Q1anWan/ControlBordL4/README.md

# ControlBordL4
A STM32 L431 Control Board  
分拣机控制器第二版  
-四层PCB  
-添加IMU  
-优化引脚引出方案
