Q1anWan/ControlBordL4/Hardware/BOM_V2.1_2022-09-01.xlsx

No. | Quantity | Comment | Designator | Footprint | Value | Manufacturer Part | Manufacturer | Supplier Part | Supplier
1 | 3 | 100nF | C1,C10,C11 | C0603 | 100nF | CC0603KRX7R9BB104 | YAGEO(国巨) | C14663 | LCSC
2 | 7 | 100nF | C2,C5,C6,C15,C16,C22,C28 | C0603 | 100nF | CL10B104KC8NNNC | SAMSUNG(三星) | C15725 | LCSC
3 | 3 | 22uF | C3,C4,C21 | C0805 | 22uF | C3216X5R1V226M160AC | TDK | C69612 | LCSC
4 | 1 | 8.2nF | C7 | C0603 | 8.2nF | 0603B822J500CT | 华新科(Walsin) | C458884 | LCSC
5 | 1 | 10pF | C8 | C0603 | 10pF | CC0603GRNPO9BN100 | YAGEO(国巨) | C325468 | LCSC
6 | 1 | 1nF | C9 | C0603 | 1nF | CL10B102KB8NNNC | SAMSUNG(三星) | C1588 | LCSC
7 | 1 | 47uF | C12 | CAP-SMD_L3.5-W2.8-R-RD | 47uF | CA45-B-16V-47uF-K | CEC(振华新云) | C136751 | LCSC
8 | 2 | 22uF | C13,C14 | C0603 | 22uF | ZRB18AR60J226ME01L | muRata(村田) | C913515 | LCSC
9 | 2 | 100nF | C17,C20 | C0402 | 100nF | CGA2B3X7R1V104MT0Y0F | TDK | C2802700 | LCSC
10 | 2 | 10uF | C18,C19 | CAP-SMD_L3.5-W2.8-R-RD | 10uF | TC211B106K025Y | Sunlord(顺络) | C110181 | LCSC
11 | 1 | 22pF | C23 | C0603 | 22pF | GCM1885C2A220JA16D | muRata(村田) | C408549 | LCSC
12 | 12 | 100nF | C24,C25,C29,C30,C31,C32,C33,C36,C40,C41,C42,C43 | C0402 | 100nF | GCM155R71C104KA55J | muRata(村田) | C2655418 | LCSC
13 | 2 | 100nF | C26,C27 | C0603 | 100nF | TCC0603X7R104K500CT | CCTC(三环) | C282519 | LCSC
14 | 1 | 4.7uF | C34 | C0603 | 4.7uF | GRM188C81E475KE11D | muRata(村田) | C417145 | LCSC
15 | 1 | 10nF | C35 | C0603 | 10nF | C0603C103K1RACAUTO | KEMET(基美) | C141072 | LCSC
16 | 1 | 1uF | C37 | C0603 | 1uF | 0603F105M160NT | FH(风华) | C1689 | LCSC
17 | 2 | 20pF | C38,C39 | C0603 | 20pF | 0603CG200G500NT | FH(风华) | C165733 | LCSC
18 | 1 | 3110-08SG0BK00A1 | CN2 | IDC-TH_3110-08SG0BK00A1 |  | 3110-08SG0BK00A1 | Wcon(维峰电子) | C720734 | LCSC
19 | 1 | X9821WVS-04-9TSN | CN3 | CONN-SMD_4P-P1.25_X9821WVS-04-9TSN |  | X9821WVS-04-9TSN | XKB Connectivity(中国星坤) | C397365 | LCSC
20 | 1 | XT30UPB-M | CN11 | CONN-TH_XT30UPB-M |  | XT30UPB-M | AMASS(艾迈斯) | C428721 | LCSC
21 | 1 | XT30UPB-F | CN12 | CONN-TH_XT30UPB-F |  | XT30UPB-F | AMASS(艾迈斯) | C108769 | LCSC
22 | 2 | A1257WR-S-2P | CN13,CN14 | CONN-SMD_A1257WR-S-2P |  | A1257WR-S-2P | CJT(长江连接器) | C225125 | LCSC
23 | 2 | DSK310 | D1,D3 | SOD-123_L2.7-W1.8-LS3.7-RD |  | DSK310 | LGE(鲁光) | C713648 | LCSC
24 | 1 | ZMM9V1 | D2 | LL-34_L3.5-W1.5-RD |  | ZMM9V1 | Slkor(萨科微) | C707200 | LCSC
25 | 10 | PESD5V0L1BA | D4,D5,D6,D7,D8,D9,D10,D11,D12,D13 | SOD-323_L1.7-W1.3-LS2.5-BI |  | PESD5V0L1BA | TECH PUBLIC(台舟) | C2827691 | LCSC
26 | 4 | M2.5 | H1,H2,H3,H4 | M2.5
27 | 1 | 6.8uH | L1 | IND-SMD_L6.6-W6.6 | 6.8uH | SMMS0630-6R8M | SXN(顺翔诺) | C128690 | LCSC
28 | 1 | 4.7uH | L2 | IND-SMD_L4.5-W4.0-1 | 4.7uH | MCS0420-4R7MPN2 | PSA(信昌电陶) | C2937092 | LCSC
29 | 2 | NCD0805R1 | LED1,LED2 | LED0805-RD_RED |  | NCD0805R1 | 国星光电 | C84256 | LCSC
30 | 1 | HL-PCF-3216S39FU70GH203BC-A | LED3 | LED-SMD_4P-L3.2-W1.5-BL |  | HL-PCF-3216S39FU70GH203BC-A | HONGLITRONIC(鸿利光电) | C513366 | LCSC
31 | 1 | WSD3066DN33 | Q1 | DFN-8_L3.3-W3.3-P0.65-BL |  | WSD3066DN33 | WINSOK微硕 | C148386 | LCSC
32 | 1 | AO3400 | Q2 | SOT-23_L2.9-W1.3-P1.90-LS2.4-BR |  | AO3400 | GOODWORK(固得沃克) | C2938367 | LCSC
33 | 1 | PMBT3904,235 | Q3 | SOT-23-3_L2.9-W1.3-P1.90-LS2.3-BR-1 |  | PMBT3904,235 | Nexperia(安世) | C179417 | LCSC
34 | 1 | 10kΩ | R1 | R0603 | 10kΩ | AR03BTD1002 | Viking(光颉) | C2992491 | LCSC
35 | 4 | 0Ω | R2,R5,R9,R20 | R0805 | 0Ω | 0805W8F0000T5E | UNI-ROYAL(厚声) | C17477 | LCSC
36 | 1 | 47kΩ | R3 | R0603 | 47kΩ | RS-03K473JT | FH(风华) | C115419 | LCSC
37 | 2 | 40.2kΩ | R4,R10 | R0603 | 40.2kΩ | TC0325B4022T5E | UNI-ROYAL(厚声) | C95611 | LCSC
38 | 1 | 5.1kΩ | R6 | R0603 | 5.1kΩ | RG1608P-512-B-T5 | SUSUMU | C332218 | LCSC
39 | 2 | 7.68kΩ | R7,R11 | R0603 | 7.68kΩ | RMC06037.68K1%N | Tyohm(幸亚电阻) | C269511 | LCSC
40 | 3 | 5.1kΩ | R8,R13,R14 | R0603 | 5.1kΩ | RMC06035.1K1%N | Tyohm(幸亚电阻) | C269716 | LCSC
41 | 1 | 5.1kΩ | R12 | R0603 | 5.1kΩ | RMC06035.1K5%N | Tyohm(幸亚电阻) | C269696 | LCSC
42 | 2 | 56Ω | R15,R16 | R0603 | 56Ω | CR0603JA0560G | LIZ(丽智电子) | C101366 | LCSC
43 | 3 | 120Ω | R17,R18,R19 | R0603 | 120Ω | RTT03121JTP | RALEC(旺诠) | C103256 | LCSC
44 | 1 | 10.2kΩ | R21 | R0603 | 10.2kΩ | 0603WAF1022T5E | UNI-ROYAL(厚声) | C22772 | LCSC
45 | 1 | 5.1kΩ | R22 | R0603 | 5.1kΩ | RS-03K512JT | FH(风华) | C73801 | LCSC
46 | 3 | 2.1kΩ | R23,R24,R25 | R0603 | 2.1kΩ | 0603WAF2101T5E | UNI-ROYAL(厚声) | C22902 | LCSC
47 | 2 | 10kΩ | R26,R27 | R0603 | 10kΩ | SG73P1JTTD1002F | KOA | C880254 | LCSC
48 | 2 | YD-3410 | SW1,SW2 | SW-SMD_L3.9-W2.9-LS4.8-EH-A |  | YD-3410 |  | C9900006416 | LCSC
49 | 1 | TPS54531DDAR | U1 | SOIC-8_L5.0-W4.0-P1.27-LS6.0-BL-EP2.0 |  | TPS54531DDAR | TI(德州仪器) | C50605 | LCSC
50 | 1 | SK6019AD4-33 | U2 | XDFN-4_L1.0-W1.0-P0.65-BL-EP |  | SK6019AD4-33 | 洺太电子(suntek) | C2682762 | LCSC
51 | 1 | RY8411 | U3 | SOT-23-6_L2.9-W1.6-P0.95-LS2.8-TL |  | RY8411 | RYCHiP(蕊源) | C2935411 | LCSC
52 | 1 | CH340N | U4 | SOP-8_L4.9-W3.9-P1.27-LS6.0-BL |  | CH340N | WCH(南京沁恒) | C2977777 | LCSC
53 | 7 | PH-00014 | U5,U24,U25,U26,U27,U28,U29 | HDR-TH_3P-P2.54-V-M |  | PH-00014 | Liansheng(连盛) | C2685130 | LCSC
54 | 1 | TJA1042T/1J | U6 | SOIC-8_L5.0-W4.0-P1.27-LS6.0-BL |  | TJA1042T/1J | NXP(恩智浦) | C53670 | LCSC
55 | 1 | STM32L431RCT6 | U7 | LQFP-64_L10.0-W10.0-P0.50-LS12.0-BL |  | STM32L431RCT6 | ST(意法半导体) | C92468 | LCSC
56 | 1 | BMI160 | U8 | LGA-14_L3.0-W2.5-P0.50-BL |  | BMI160 | Bosch(博世) | C94021 | LCSC
57 | 1 | 74HC245PW | U11 | TSSOP-20_L6.5-W4.4-P0.65-LS6.4-BL |  | 74HC245PW |  | C443919 | LCSC
58 | 1 | GH1.25-4PWBPZ | U30 | CONN-SMD_GH1.25-4PWBPZ |  | GH1.25-4PWBPZ | BOOMELE(博穆精密) | C2829253 | LCSC
59 | 1 | TYPE-C 16PIN 3MD(385) | USB1 | USB-C-SMD_TYPE-C16PIN |  | TYPE-C 16PIN 3MD(385) | SHOU HAN(首韩) | C2858270 | LCSC
60 | 1 | 8MHz | X1 | OSC-SMD_4P-L3.2-W2.5-BL | 8MHz | X32258MOB4SI | YXC扬兴科技 | C2682775 | LCSC
