Q1anWan/ControlBordL4/Hardware/DXF_PCB2_2022-08-15.dxf

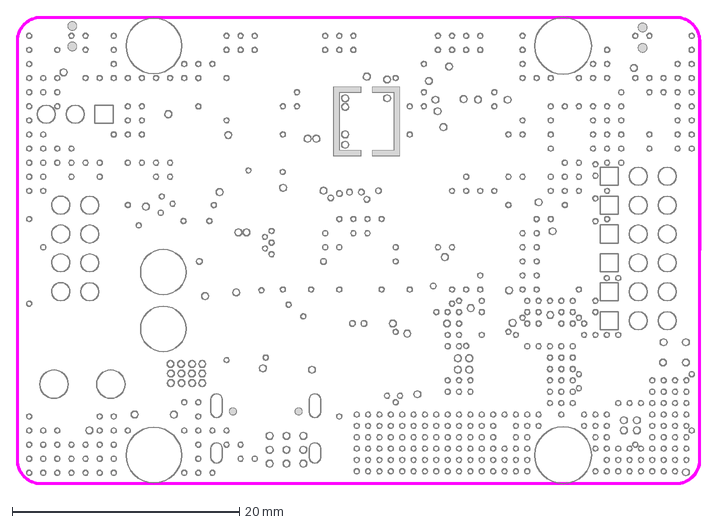
[picture p17: CAD file, 2022-08-27]
Hardware/DXF_PCB2_2022-08-15.dxf
60.3 x 41.3 mm
