Q1anWan/ControlBordL4/Hardware/SCH_V2.1_2022-09-01.pdf

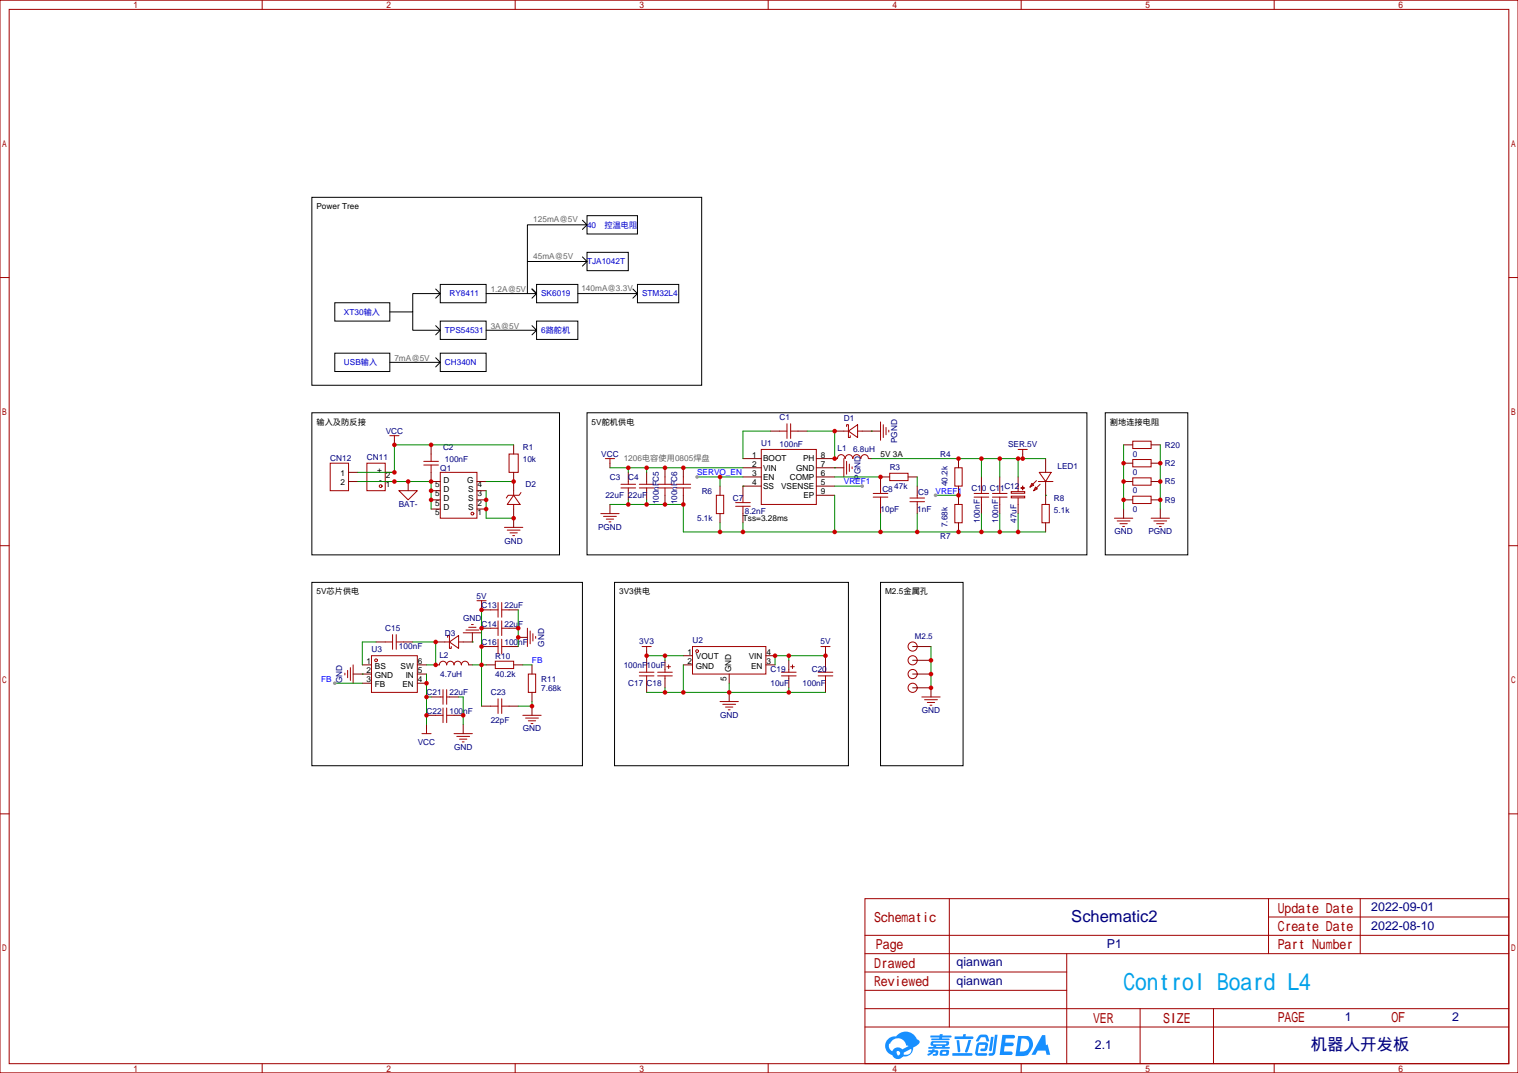
[picture p18: page 1]

GND B1A12 VBUS B4A9 SBU2 B8 DN2 B7 DP2 B6 CC2 B5 SBU1 A8 DN1 A7 DP1 A6 CC1 A5 VBUS A4B9 GND A1B12

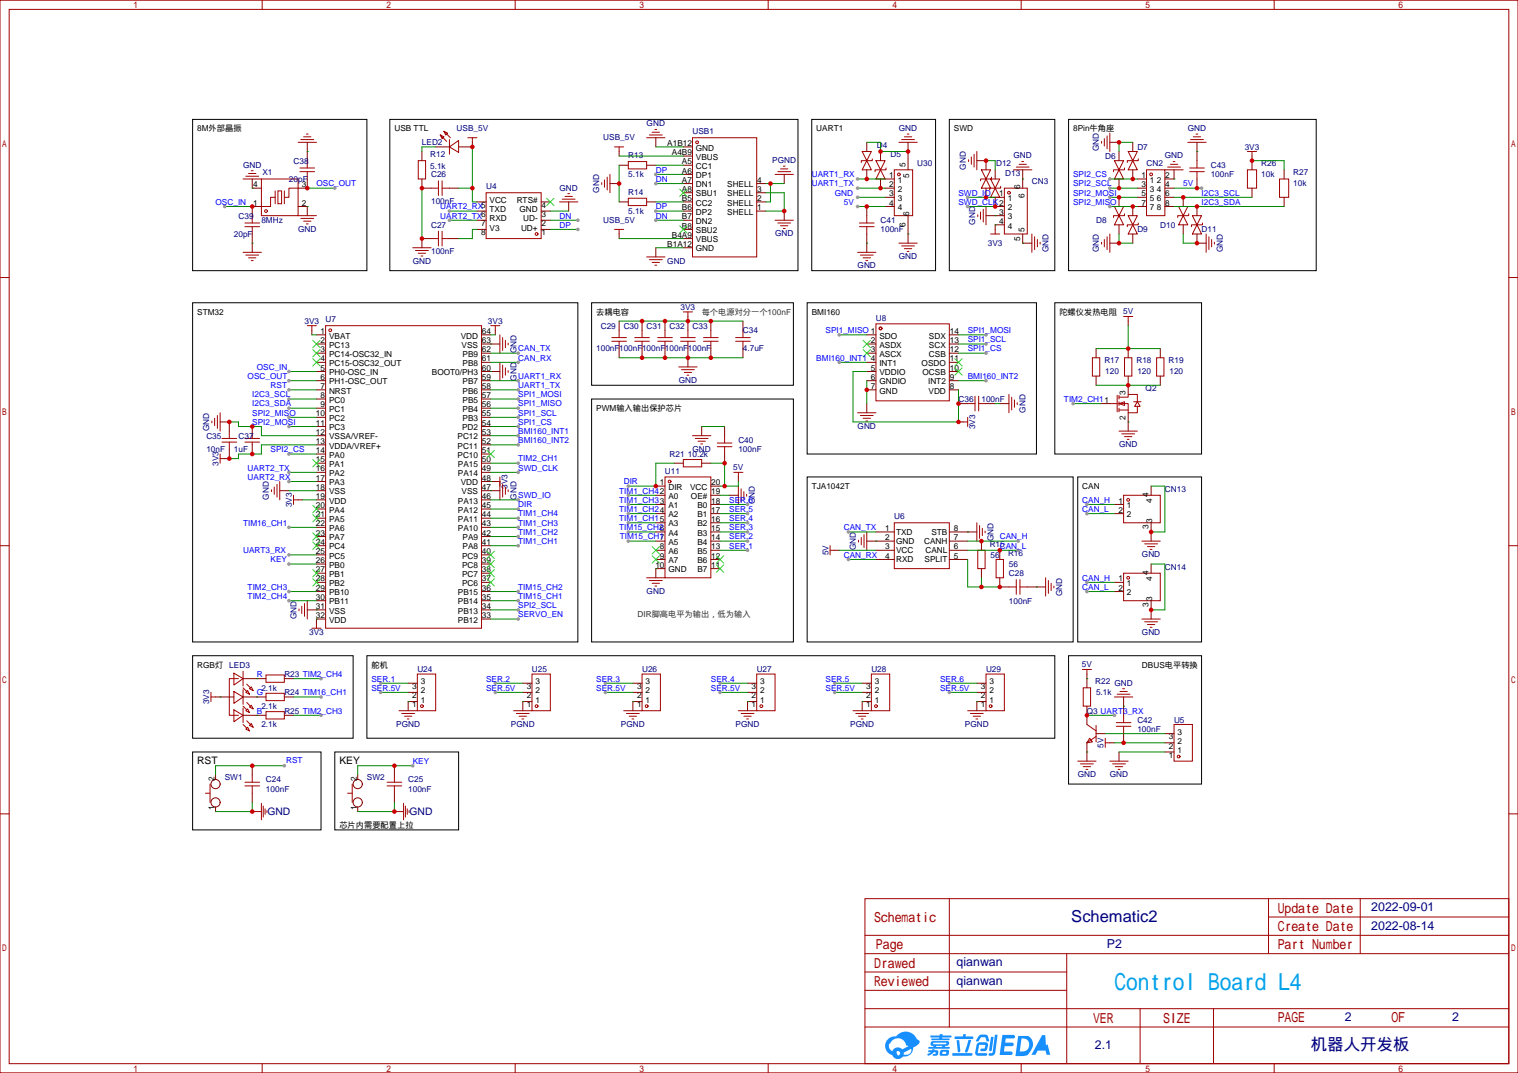
[picture p19: page 2]
