Q1anWan/ControlBordL4/Hardware/SCH_Schematic2_2022-08-15.pdf

## C10100nF

## C11100nF

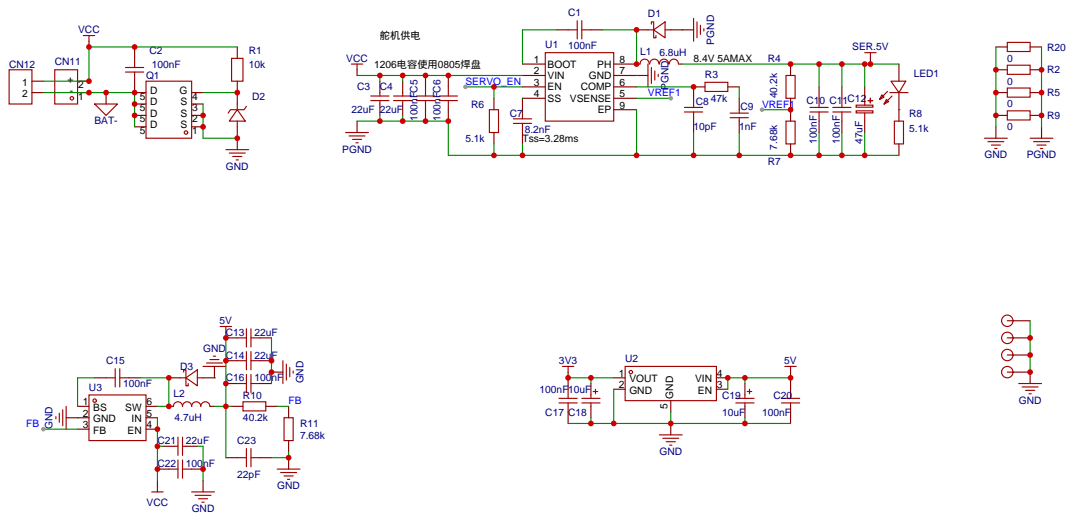
[picture p20: page 1]

GND B1A12 VBUS B4A9 SBU2 B8 DN2 B7 DP2 B6 CC2 B5 SBU1 A8 DN1 A7 DP1 A6 CC1 A5 VBUS A4B9 GND A1B12

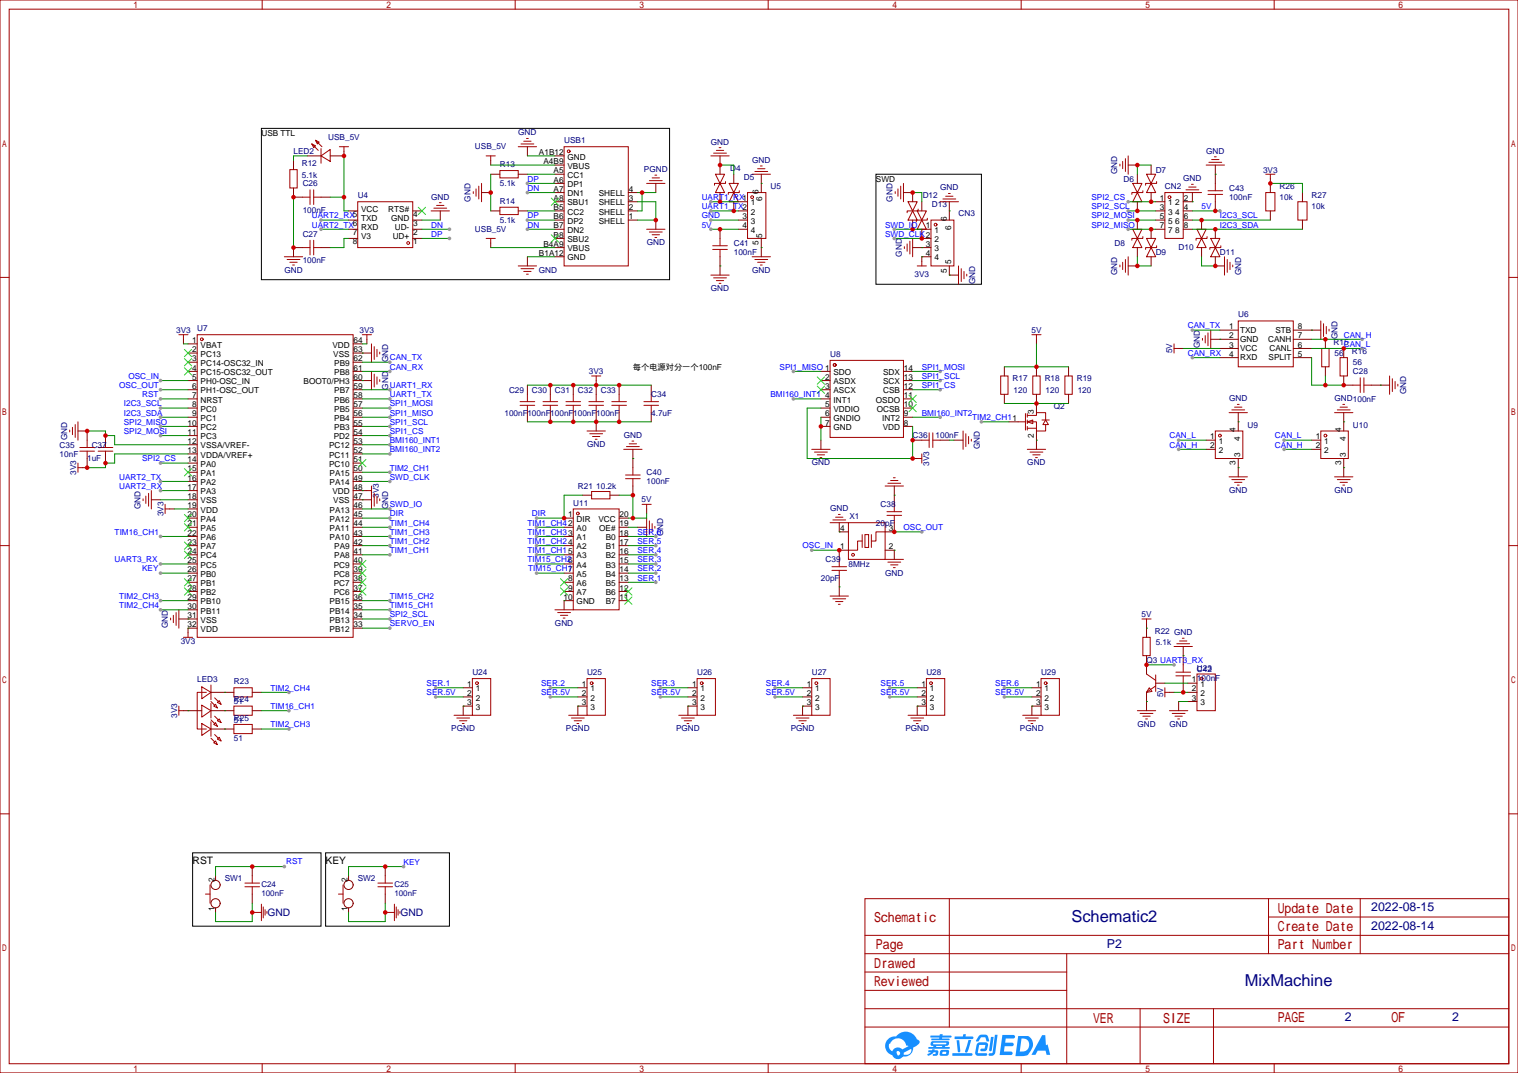
[picture p21: page 2]

OCSB 10 OSDO 11 CSB 12 SCX 13 SDX 14
