Q1anWan/ControlBordL4/Hardware/PCB_V.21_2022-09-01.pdf

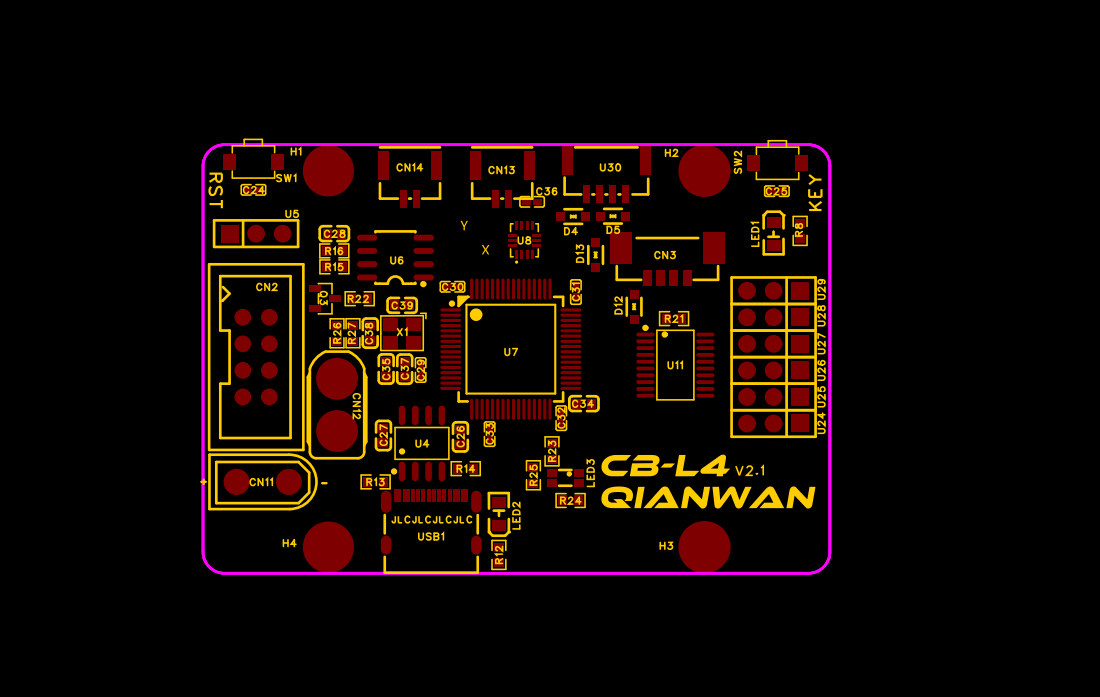
[picture p22: page 1]

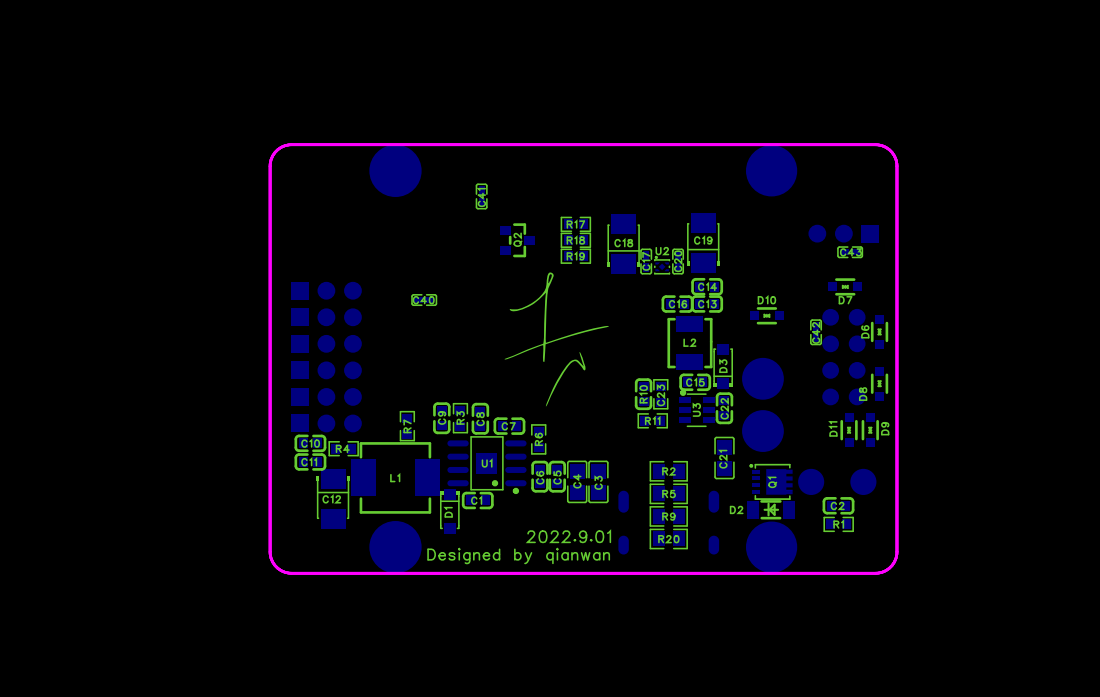
[picture p23: page 2]
