Q1anWan/ControlBordL4/Software/Mix_Machine_L4.ioc

Mcu.UserName=STM32L431RCTx
PA0.GPIO_Label=SPI2_CS
PA0.Signal=GPIO_Output
PA10.Signal=S_TIM1_CH3
PA11.Signal=S_TIM1_CH4
PA12.GPIO_Label=DIR
PA12.Signal=GPIO_Output
PA2.Signal=USART2_TX
PA3.Signal=USART2_RX
PA6.Signal=S_TIM16_CH1
PA8.Signal=S_TIM1_CH1
PA9.Signal=S_TIM1_CH2
PB0.GPIO_Label=KEY
PB0.Signal=GPXTI0
PB10.Signal=S_TIM2_CH3
PB11.Signal=S_TIM2_CH4
PB12.GPIO_Label=SERVO_EN
PB12.Signal=GPIO_Output
PB13.Signal=SPI2_SCK
PB14.Signal=S_TIM15_CH1
PB15.Signal=S_TIM15_CH2
PB5.Signal=SPI1_MOSI
PB6.Signal=USART1_TX
PB7.Signal=USART1_RX
PB8.Signal=CAN1_RX
PB9.Signal=CAN1_TX
PC0.Signal=I2C3_SCL
PC1.Signal=I2C3_SDA
PC11.GPIO_Label=BMI160_INT2
PC11.Signal=GPXTI11
PC12.GPIO_Label=BMI160_INT1
PC12.Signal=GPXTI12
PC2.Signal=SPI2_MISO
PC3.Signal=SPI2_MOSI
PC4.Signal=USART3_TX
PC5.Signal=USART3_RX
PD2.GPIO_Label=SPI1_CS
PD2.Signal=GPIO_Output
