Q1anWan/ControlBordL4/Software/Core/Inc/main.h

#define SPI2_CS_Pin LL_GPIO_PIN_0
#define SPI2_CS_GPIO_Port GPIOA
#define KEY_Pin LL_GPIO_PIN_0
#define KEY_GPIO_Port GPIOB
#define KEY_EXTI_IRQn EXTI0_IRQn
#define SERVO_EN_Pin LL_GPIO_PIN_12
#define SERVO_EN_GPIO_Port GPIOB
#define DIR_Pin LL_GPIO_PIN_12
#define DIR_GPIO_Port GPIOA
#define BMI160_INT2_Pin LL_GPIO_PIN_11
#define BMI160_INT2_GPIO_Port GPIOC
#define BMI160_INT2_EXTI_IRQn EXTI15_10_IRQn
#define BMI160_INT1_Pin LL_GPIO_PIN_12
#define BMI160_INT1_GPIO_Port GPIOC
#define BMI160_INT1_EXTI_IRQn EXTI15_10_IRQn
#define SPI1_CS_Pin LL_GPIO_PIN_2
#define SPI1_CS_GPIO_Port GPIOD
