Q1anWan/ControlBordL4/Software/Modules/DMA_LL.cpp

/*
	DMA LowLayer库DMA支持
	  千万 2022.9.3
	  F1 F4 G0 G4 H7
	  Version:1.1
*/
#include "DMA_LL.h"
/*是否启用DMA*/
#if (defined(DMA1) || defined(DMA2) || defined(DMA3))&&(MY_DMA_ENABLE==1)

#ifndef LL_DMA_STREAM_1
void DMA_C::DMA_InitConfig(DMA_TypeDef *DMAx, uint32_t Channel)
{
	this->DMAx = DMAx;
	this->DMA_Channelx = Channel;
}

void DMA_C::DMA_EnableCH(void)
{
	LL_DMA_EnableChannel(this->DMAx, this->DMA_Channelx);
}
void DMA_C::DMA_DisableCH(void)
{
	LL_DMA_DisableChannel(this->DMAx, this->DMA_Channelx);
}

#if defined(DMA_IFCR_CTCIF1)
void DMA_C::DMA_Clear_TC(void)
{
	switch (this->DMA_Channelx)
	{
	case LL_DMA_CHANNEL_1:
		LL_DMA_ClearFlag_TC1(this->DMAx);
		break;
	case LL_DMA_CHANNEL_2:
		LL_DMA_ClearFlag_TC2(this->DMAx);
		break;
	case LL_DMA_CHANNEL_3:
		LL_DMA_ClearFlag_TC3(this->DMAx);
		break;
	case LL_DMA_CHANNEL_4:
		LL_DMA_ClearFlag_TC4(this->DMAx);
		break;
#if defined(DMA1_Channel5)
	case LL_DMA_CHANNEL_5:
		LL_DMA_ClearFlag_TC5(this->DMAx);
		break;
#endif
#if defined(DMA1_Channel6)
	case LL_DMA_CHANNEL_6:
		LL_DMA_ClearFlag_TC6(this->DMAx);
		break;
#endif
#if defined(DMA1_Channel7)
	case LL_DMA_CHANNEL_7:
		LL_DMA_ClearFlag_TC7(this->DMAx);
		break;
#endif
#if defined(DMA1_Channel8)
	case LL_DMA_CHANNEL_8:
		LL_DMA_ClearFlag_TC8(this->DMAx);
		break;
#endif
	}
}
#endif

#if defined(DMA_IFCR_CHTIF1)
void DMA_C::DMA_Clear_HT(void)
{
	switch (this->DMA_Channelx)
	{
	case LL_DMA_CHANNEL_1:
		LL_DMA_ClearFlag_HT1(this->DMAx);
		break;
	case LL_DMA_CHANNEL_2:
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
	case LL_DMA_STREAM_5:
		LL_DMA_ClearFlag_DME5(this->DMAx);
		break;
#endif
#if defined(DMA1_Stream6)
	case LL_DMA_STREAM_6:
		LL_DMA_ClearFlag_DME6(this->DMAx);
		break;
#endif
#if defined(DMA1_Stream7)
	case LL_DMA_STREAM_7:
		LL_DMA_ClearFlag_DME7(this->DMAx);
		break;
#endif
	}
}
#endif

#if defined(DMA_LIFCR_CFEIF1)
void DMA_C::DMA_Clear_FE(void)
{
	switch (this->DMA_Channelx)
	{
	case LL_DMA_STREAM_0:
		LL_DMA_ClearFlag_FE0(this->DMAx);
		break;
	case LL_DMA_STREAM_1:
		LL_DMA_ClearFlag_FE1(this->DMAx);
		break;
	case LL_DMA_STREAM_2:
		LL_DMA_ClearFlag_FE2(this->DMAx);
		break;
	case LL_DMA_STREAM_3:
		LL_DMA_ClearFlag_FE3(this->DMAx);
		break;
#if defined(DMA1_Stream4)
	case LL_DMA_STREAM_4:
		LL_DMA_ClearFlag_FE4(this->DMAx);
		break;
#endif
#if defined(DMA1_Stream5)
	case LL_DMA_STREAM_5:
		LL_DMA_ClearFlag_FE5(this->DMAx);
		break;
#endif
#if defined(DMA1_Stream6)
	case LL_DMA_STREAM_6:
		LL_DMA_ClearFlag_FE6(this->DMAx);
		break;
#endif
#if defined(DMA1_Stream7)
	case LL_DMA_STREAM_7:
		LL_DMA_ClearFlag_FE7(this->DMAx);
		break;
#endif
	}
}
#endif
#endif
#endif
