Q1anWan/ControlBordL4/Modules/Flash_M4_HAL.h

/*****************************************************************
**                大连理工大学 凌BUG战队
**    没有什么难题是一个通宵解决不了的，如果有那就整两个！
**---------------------------------------------------------------
** 项目名称：   mxdemo_std_robot
** 日    期：   2021-04-15
** 作    者：   MasterWang
**---------------------------------------------------------------
** 文 件 名：   flash.c
** 文件说明：   读写芯片flash区,存放掉电后需保存的参数
*****************************************************************/
#ifndef FLASH_H
#define FLASH_H

/*---------------------INCLUDES----------------------*/
#include "main.h"
#include "string.h"

/*---------------------DEFINES-----------------------*/
/* Base address of the Flash sectors */
#define ADDR_FLASH_SECTOR_0 ((uint32_t)0x08000000)  /* Base address of Sector 0, 16 Kbytes   */
#define ADDR_FLASH_SECTOR_1 ((uint32_t)0x08004000)  /* Base address of Sector 1, 16 Kbytes   */
#define ADDR_FLASH_SECTOR_2 ((uint32_t)0x08008000)  /* Base address of Sector 2, 16 Kbytes   */
#define ADDR_FLASH_SECTOR_3 ((uint32_t)0x0800C000)  /* Base address of Sector 3, 16 Kbytes   */
#define ADDR_FLASH_SECTOR_4 ((uint32_t)0x08010000)  /* Base address of Sector 4, 64 Kbytes   */
#define ADDR_FLASH_SECTOR_5 ((uint32_t)0x08020000)  /* Base address of Sector 5, 128 Kbytes  */
#define ADDR_FLASH_SECTOR_6 ((uint32_t)0x08040000)  /* Base address of Sector 6, 128 Kbytes  */
#define ADDR_FLASH_SECTOR_7 ((uint32_t)0x08060000)  /* Base address of Sector 7, 128 Kbytes  */
#define ADDR_FLASH_SECTOR_8 ((uint32_t)0x08080000)  /* Base address of Sector 8, 128 Kbytes  */
#define ADDR_FLASH_SECTOR_9 ((uint32_t)0x080A0000)  /* Base address of Sector 9, 128 Kbytes  */
#define ADDR_FLASH_SECTOR_10 ((uint32_t)0x080C0000) /* Base address of Sector 10, 128 Kbytes */
#define ADDR_FLASH_SECTOR_11 ((uint32_t)0x080E0000) /* Base address of Sector 11, 128 Kbytes */

#define ADDR_FLASH_SECTOR_12 ((uint32_t)0x08100000) /* Base address of Sector 12, 16 Kbytes  */
#define ADDR_FLASH_SECTOR_13 ((uint32_t)0x08104000) /* Base address of Sector 13, 16 Kbytes  */
#define ADDR_FLASH_SECTOR_14 ((uint32_t)0x08108000) /* Base address of Sector 14, 16 Kbytes  */
#define ADDR_FLASH_SECTOR_15 ((uint32_t)0x0810C000) /* Base address of Sector 15, 16 Kbytes  */
#define ADDR_FLASH_SECTOR_16 ((uint32_t)0x08110000) /* Base address of Sector 16, 64 Kbytes  */
#define ADDR_FLASH_SECTOR_17 ((uint32_t)0x08120000) /* Base address of Sector 17, 128 Kbytes */
#define ADDR_FLASH_SECTOR_18 ((uint32_t)0x08140000) /* Base address of Sector 18, 128 Kbytes */
#define ADDR_FLASH_SECTOR_19 ((uint32_t)0x08160000) /* Base address of Sector 19, 128 Kbytes */
#define ADDR_FLASH_SECTOR_20 ((uint32_t)0x08180000) /* Base address of Sector 20, 128 Kbytes */
#define ADDR_FLASH_SECTOR_21 ((uint32_t)0x081A0000) /* Base address of Sector 21, 128 Kbytes */
#define ADDR_FLASH_SECTOR_22 ((uint32_t)0x081C0000) /* Base address of Sector 22, 128 Kbytes */
#define ADDR_FLASH_SECTOR_23 ((uint32_t)0x081E0000) /* Base address of Sector 23, 128 Kbytes */

/*---------------------DECLARES----------------------*/
extern void flash_erase_address(uint32_t address, uint16_t num);
extern void flash_write_address(uint32_t address, uint32_t *buf, uint16_t num);
extern void flash_read_address(uint32_t address, uint32_t *buf, uint16_t num);


#endif
