Q1anWan/ControlBordL4/Software/Modules/DMA_LL.h

/*
	DMA LowLazer库DMA支持
	  千万 2022.9.3
	  F1 F4 G0 G4 H7
*/
/*
	一键清除中断
	消除Channel与Stream的差异
*/

#ifndef DMA_LL_H
#define DMA_LL_H
#include "main.h"
/*是否启用DMA*/
#define MY_DMA_ENABLE 1

#if (MY_DMA_ENABLE==1)
#include "dma.h"
#ifdef __cplusplus
class DMA_C
{
public:
	DMA_TypeDef *DMAx;
	uint32_t DMA_Channelx;

public:
	void DMA_EnableCH(void);
	void DMA_DisableCH(void);

#if defined(DMA_IFCR_CTCIF1) || defined(DMA_LIFCR_CTCIF1)
	void DMA_Clear_TC(void);
#endif
#if defined(DMA_IFCR_CHTIF1) || defined(DMA_LIFCR_CHTIF1)
	void DMA_Clear_HT(void);
#endif
#if defined(DMA_IFCR_CGIF1)
	void DMA_Clear_GI(void);
#endif
#if defined(DMA_IFCR_CTEIF1) || defined(DMA_LIFCR_CTEIF1)
	void DMA_Clear_TE(void);
#endif
#if defined(DMA_LIFCR_CDMEIF1)
	void DMA_Clear_DME(void);
#endif
#if defined(DMA_LIFCR_CFEIF1)
	void DMA_Clear_FE(void);
#endif

#ifndef LL_DMA_STREAM_1
	void DMA_InitConfig(DMA_TypeDef *DMAx, uint32_t Channel);
#endif
#ifdef LL_DMA_STREAM_1
	void DMA_InitConfig(DMA_TypeDef *DMAx, uint32_t Stream);
#endif
};

extern "C"
{
}
#endif
#endif
#endif
