Q1anWan/ControlBordL4/(commit log)

2022-08-27 验证板更新
    [DXF_PCB2_2022-08-15.dxf]
2022-08-31 Update Hardware Version 2.1
    [BOM_2022-08-15.xlsx, BOM_2022-09-01.xlsx, DXF_PCB2_2022-08-15.dxf]
2022-09-01 原理图更新
2022-09-01 Hardaware V2.1 Update
    [BOM_2022-09-01.xlsx]
2022-09-07 Add PCB Picture for assmeble
    [BOM_V2.1_2022-09-01.xlsx, PickAndPlace_V2.1_2022-09-01.csv]
2022-09-16 Software Update ADC OverSamp
